Nixiujiade/4T_BLDC/[3]原理图/4T_AS5600/AS5600.pdf

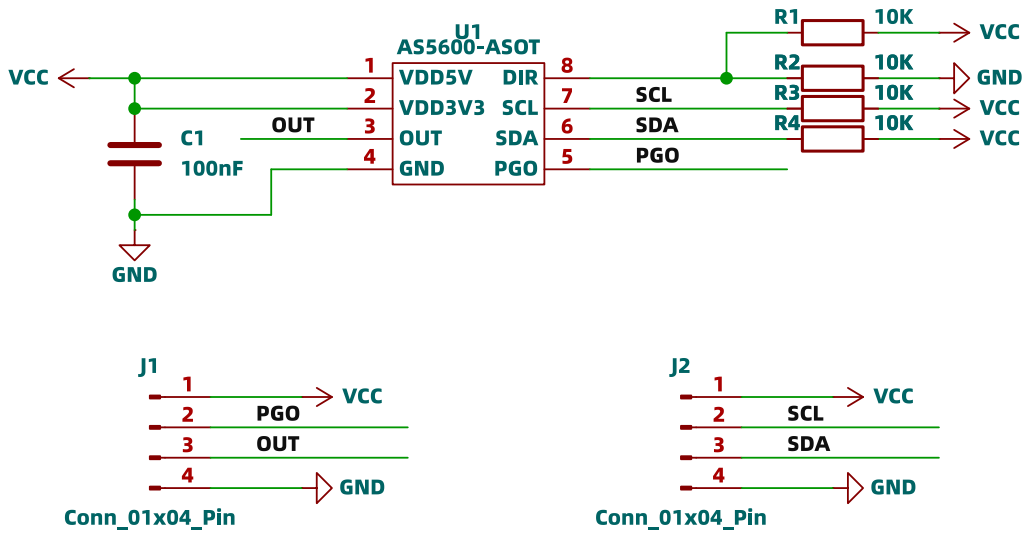
[picture p9: page 1]

Id: 1/1 Title: File: AS5600.kicad_sch Sheet: / 4T Tech
