Nixiujiade/4T_BLDC/[3]原理图/4T_FOC/4T_FOC.pdf

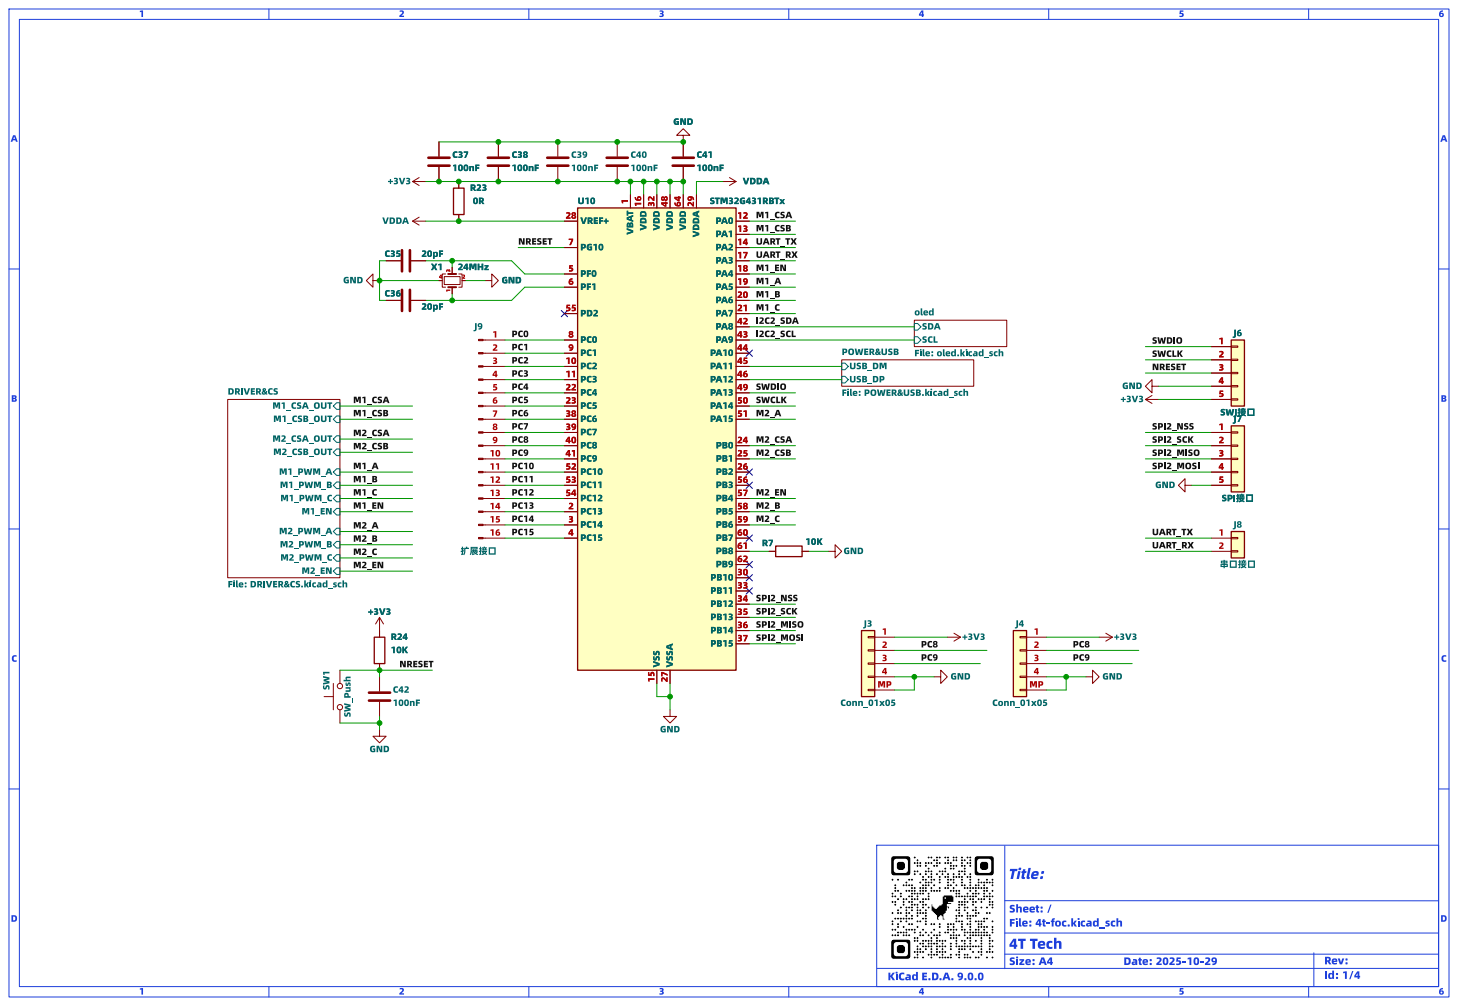
[picture p10: page 1]

1 VDD 16 VDD 32 VSS 15 VDD 48 VSSA 27 VDD 64 VDDA 29 PA0

þÿSWJc¥Sã GND

Id: 1/4 Title: File: 4t-foc.kicad_sch Sheet: / 4T Tech

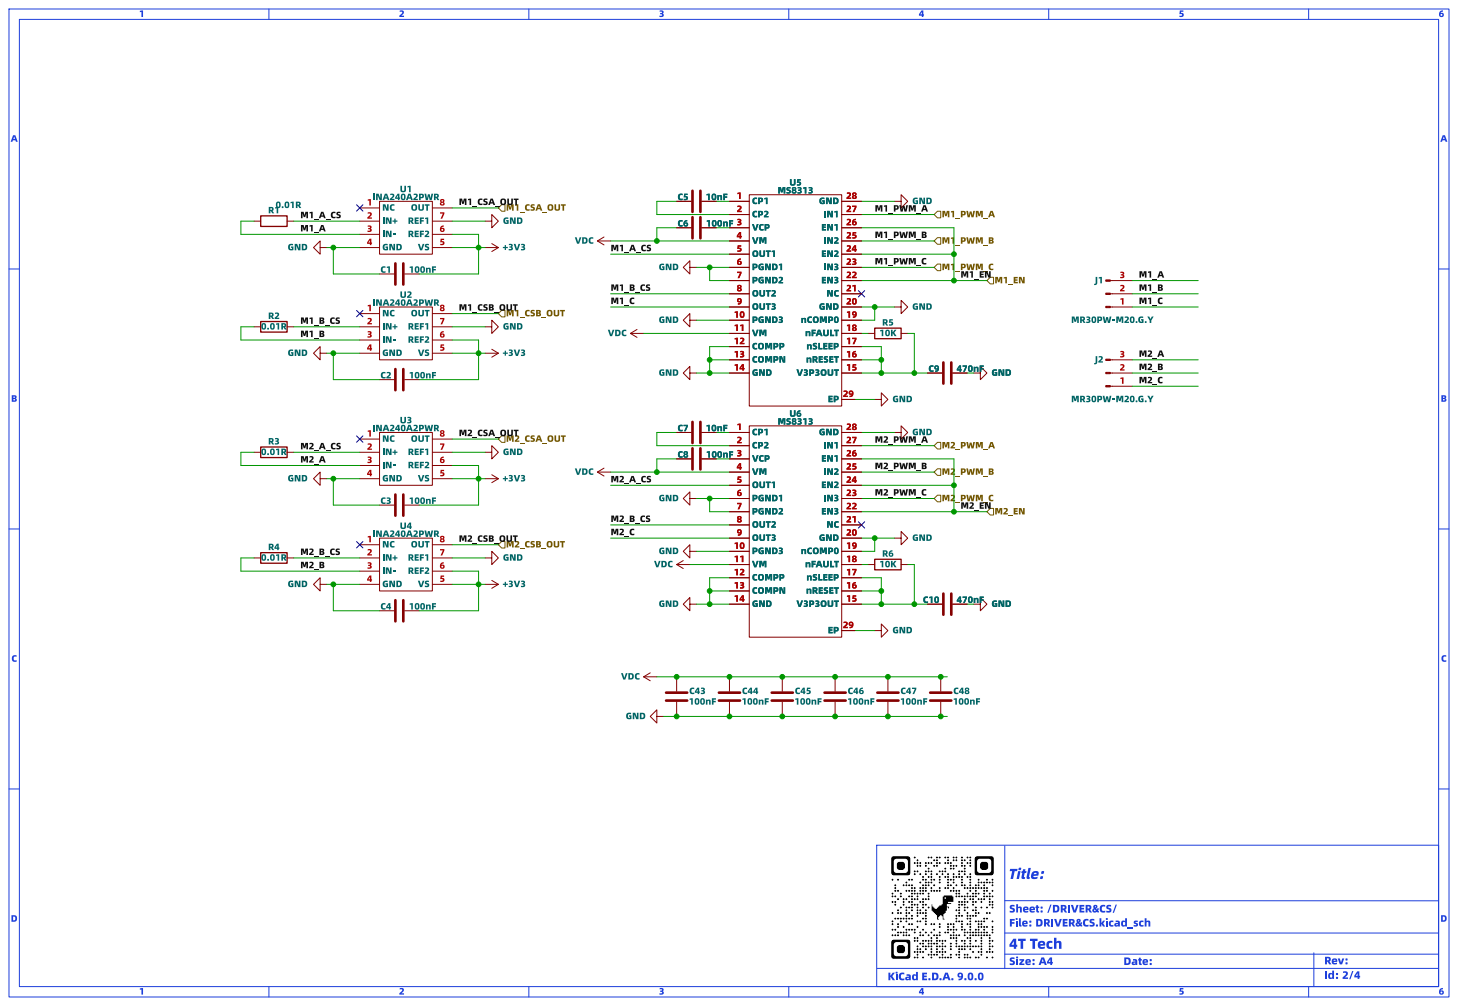
[picture p11: page 2]

Id: 2/4 Title: File: DRIVER&CS.kicad_sch Sheet: /DRIVER&CS/ 4T Tech

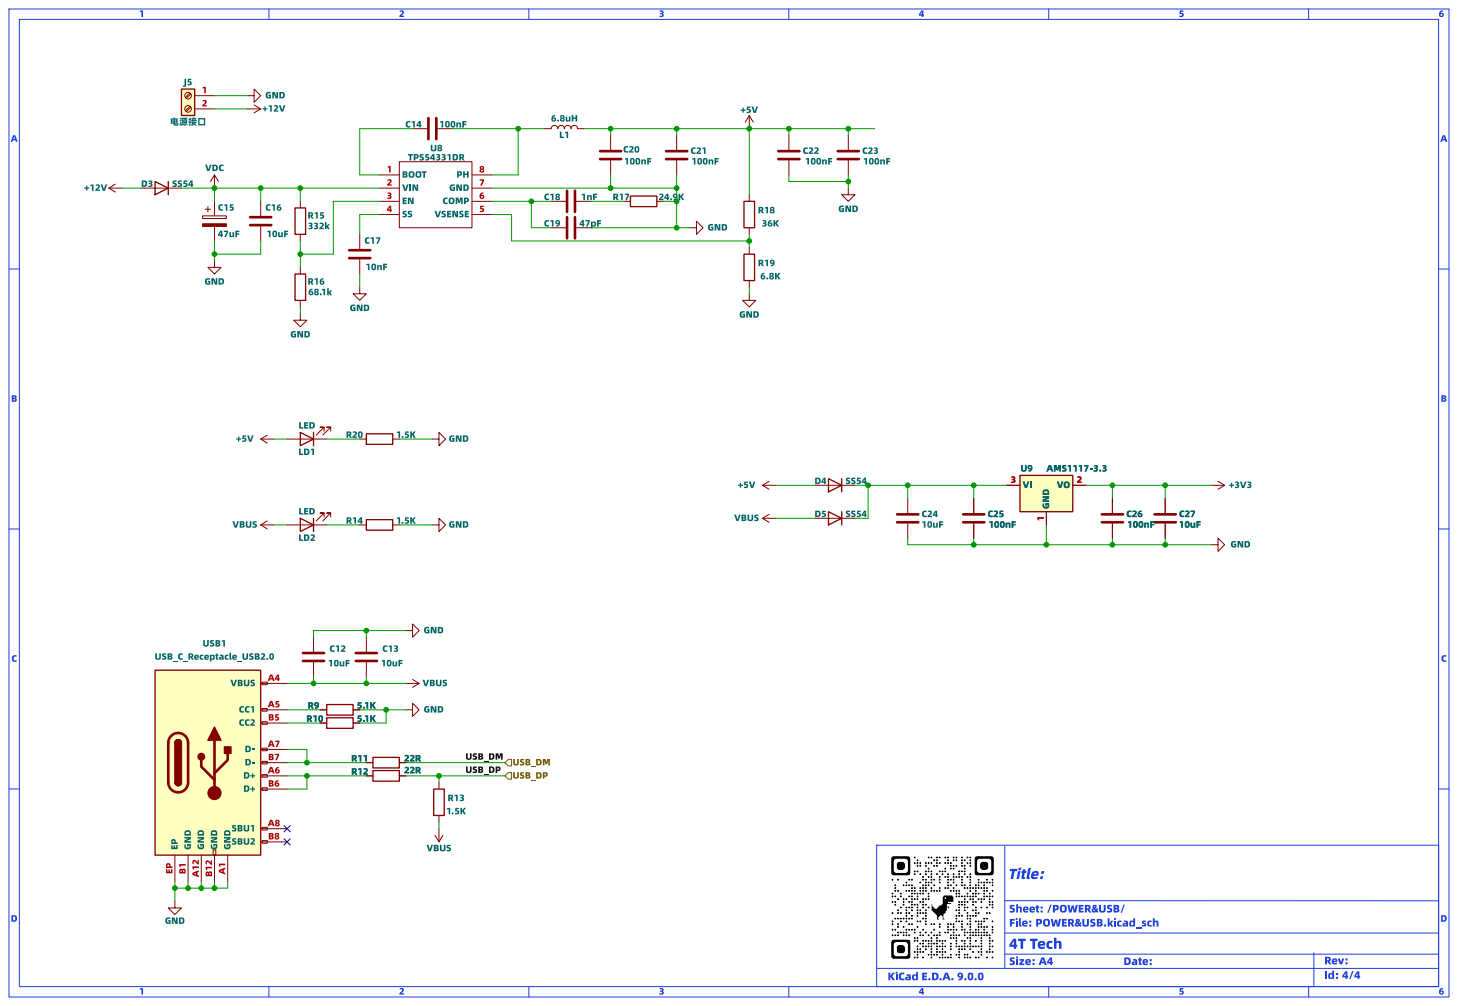
[picture p12: page 3]

Id: 4/4 Title: File: POWER&USB.kicad_sch Sheet: /POWER&USB/ 4T Tech

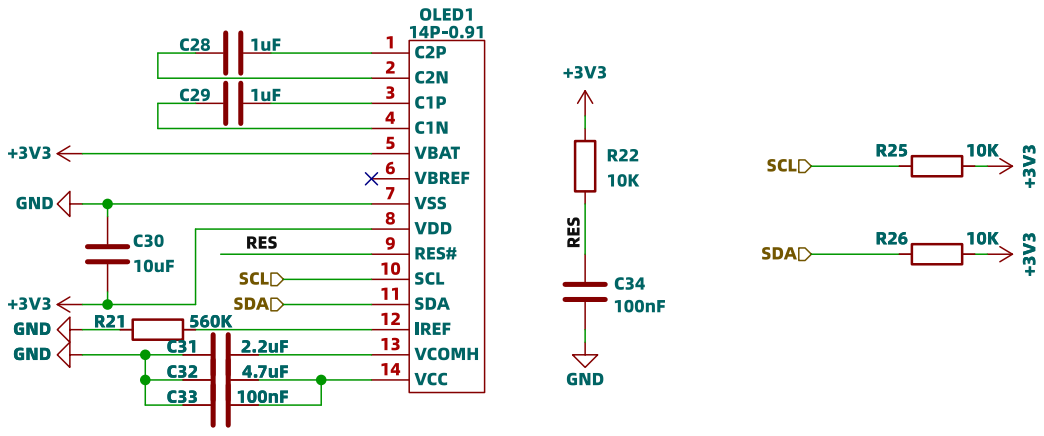
[picture p13: page 4]

Id: 5/4 Title: File: oled.kicad_sch Sheet: /oled/ 4T Tech
