Nixiujiade/4T_BLDC/[2]测试程序/MDK/Core/Src/main.c

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
/* Includes ------------------------------------------------------------------*/
#include "main.h"
#include "adc.h"
#include "dma.h"
#include "i2c.h"
#include "tim.h"
#include "usart.h"
#include "gpio.h"

/* USER CODE BEGIN Includes */
float target = 2;
float now_us1,now_us2;
/* USER CODE END Includes */


void SystemClock_Config(void);
/**
  * @brief  The application entry point.
  * @retval int
  */
int main(void)
{
  /* MCU Configuration--------------------------------------------------------*/

  /* Reset of all peripherals, Initializes the Flash interface and the Systick. */
  HAL_Init();

  /* Configure the system clock */
  SystemClock_Config();

  /* Initialize all configured peripherals */
  MX_GPIO_Init();
  MX_DMA_Init();
  MX_ADC1_Init();
  MX_ADC2_Init();
  MX_TIM2_Init();
  MX_TIM3_Init();
  MX_I2C3_Init();
  MX_USART2_UART_Init();
  MX_I2C2_Init();
  /* USER CODE BEGIN 2 */
	Debug_Init();
	
	HAL_TIM_PWM_Start(&htim2,TIM_CHANNEL_1);
	HAL_TIM_PWM_Start(&htim3,TIM_CHANNEL_1);
  HAL_TIM_PWM_Start(&htim3,TIM_CHANNEL_2);
	HAL_Delay(1000);
	MagneticSensor_Init();
	
	LPF_init();                //LPF参数初始化
	PID_init();                //PID参数初始化
	
	voltage_power_supply=12;   //V 电源电压
	pole_pairs=7;              //电机极对数，按照实际设置，虽然可以上电检测但有失败的概率
	voltage_sensor_align=1;    //V alignSensor() use it，航模电机设置的值小一点比如0.5-1，云台电机设置的大一点比如2-3
	voltage_limit=4.5;         //V，主要为限制电机最大电流，最大值需小于12/1.732=6.9
	velocity_limit=20;         //rad/s 角度模式时限制最大转速，力矩模式和速度模式不起作用
	current_limit=0.2;          //A，foc_current 和dc_current模式限制电流，不能为0。速度模式和位置模式起作用
	torque_controller=Type_voltage;  //Type_dc_current;//  Type_foc_current;  //Type_voltage;
	controller=Type_angle;  //Type_torque;  //Type_velocity;  //Type_angle; 
	PID_velocity.output_ramp=30; //速度爬升斜率，如果不需要可以设置为0
	LPF_velocity.Tf=0.001;      //Tf设置小一点，配合爬升斜率设置，速度切换更平稳；如果没有爬升模式的斜率限制，Tf太小电机容易抖动。
	target=10;
	
	M0_Enable;
	
	Motor_init();
	Motor_initFOC(0,UNKNOWN);  //(0,UNKNOWN);  //(1.1,CW); 第一次先获得偏移角和方向，填入代码编译后再下载，以后可以跳过零点校准
	printf("Motor ready.\r\n");
	
	
	oled_init();
  /* USER CODE END 2 */
	

  /* Infinite loop */
  /* USER CODE BEGIN WHILE */
  while (1)
  {
    /* USER CODE END WHILE */

    /* USER CODE BEGIN 3 */
		move(target);
		loopFOC();
	}
  /* USER CODE END 3 */
}

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
/* USER CODE BEGIN 4 */
int fputc(int ch,FILE *f)
{
	uint8_t temp[1]={ch};
	LL_USART_TransmitData8(USART2,temp[0]);
	while(!LL_USART_IsActiveFlag_TXE(USART2));//需要等待发送完成
	return(ch);
}
/* USER CODE END 4 */

/**
  * @brief  Period elapsed callback in non blocking mode
  * @note   This function is called  when TIM1 interrupt took place, inside
  * HAL_TIM_IRQHandler(). It makes a direct call to HAL_IncTick() to increment
  * a global variable "uwTick" used as application time base.
  * @param  htim : TIM handle
  * @retval None
  */
void HAL_TIM_PeriodElapsedCallback(TIM_HandleTypeDef *htim)
{
  if (htim->Instance == TIM1) {
    HAL_IncTick();
  }
}

/**
  * @brief  This function is executed in case of error occurrence.
  * @retval None
  */
void Error_Handler(void)
{
  /* USER CODE BEGIN Error_Handler_Debug */
  /* User can add his own implementation to report the HAL error return state */
  __disable_irq();
  while (1)
  {
  }
  /* USER CODE END Error_Handler_Debug */
}

#ifdef  USE_FULL_ASSERT
/**
  * @brief  Reports the name of the source file and the source line number
  *         where the assert_param error has occurred.
  * @param  file: pointer to the source file name
  * @param  line: assert_param error line source number
  * @retval None
  */
void assert_failed(uint8_t *file, uint32_t line)
{
  /* USER CODE BEGIN 6 */
  /* User can add his own implementation to report the file name and line number,
     ex: printf("Wrong parameters value: file %s on line %d\r\n", file, line) */
  /* USER CODE END 6 */
}
#endif /* USE_FULL_ASSERT */
