Nixiujiade/4T_BLDC/[2]测试程序/MDK/ll_4tfoc.ioc

Mcu.UserName=STM32G431RBTx
PA0.Signal=ADC1_IN1
PA1.Signal=ADC2_IN2
PA11.Signal=USB_DM
PA12.Signal=USB_DP
PA13.Signal=SYS_JTMS-SWDIO
PA14.Signal=SYS_JTCK-SWCLK
PA15.Signal=S_TIM8_CH1
PA2.Signal=USART2_TX
PA3.Signal=USART2_RX
PA4.Signal=GPIO_Output
PA5.Signal=S_TIM2_CH1
PA6.Signal=S_TIM3_CH1
PA7.Signal=S_TIM3_CH2
PA8.Signal=I2C2_SDA
PA9.Signal=I2C2_SCL
PB0.Signal=ADC1_IN15
PB1.Signal=ADC1_IN12
PB12.Signal=SPI2_NSS
PB13.Signal=SPI2_SCK
PB14.Signal=SPI2_MISO
PB15.Signal=SPI2_MOSI
PB4.Signal=GPIO_Output
PB5.Signal=S_TIM17_CH1
PB6.Signal=S_TIM4_CH1
PC8.Signal=I2C3_SCL
PC9.Signal=I2C3_SDA
PF0-OSC_IN.Signal=RCC_OSC_IN
PF1-OSC_OUT.Signal=RCC_OSC_OUT
