Nixiujiade/4T_BLDC/[2]测试程序/MDK/foc/BLDCMotor.h

#ifndef BLDCMotor_H
#define BLDCMotor_H

#include "main.h"


typedef enum
{
    CW      = 1,  //clockwise
    CCW     = -1, // counter clockwise
    UNKNOWN = 0   //not yet known or invalid state
} Direction;

extern long sensor_direction;
extern float voltage_power_supply;
extern float voltage_limit;
extern float voltage_sensor_align;
extern int  pole_pairs;
extern unsigned long open_loop_timestamp;
extern float velocity_limit;
extern float current_limit;

void Motor_init(void);
void Motor_initFOC(float zero_electric_offset, Direction _sensor_direction);
void loopFOC(void);
void move(float new_target);
void setPhaseVoltage(float Uq, float Ud, float angle_el);


#endif
