Nixiujiade/4T_BLDC/[2]测试程序/MDK/foc/Encoder.h

#ifndef __ENCODER_LIB_H
#define __ENCODER_LIB_H


#include "stm32g4xx.h"

/******************************************************************************/
/******************************************************************************/
void TIM3_Encoder_Init(void);
uint16_t ReadABZ(void);
void EXTI_Encoder_Init(void);
/******************************************************************************/

#endif
