Nixiujiade/4T_BLDC/[2]测试程序/MDK/Core/Inc/main.h

#define M0_Enable    HAL_GPIO_WritePin(GPIOA, GPIO_PIN_4, GPIO_PIN_SET); 
#define M0_Disable   HAL_GPIO_WritePin(GPIOA, GPIO_PIN_4, GPIO_PIN_RESET);   
