Nixiujiade/4T_BLDC/[2]测试程序/MDK/Core/Src/adc.c

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
/* Includes ------------------------------------------------------------------*/
#include "adc.h"

/* ADC1 init function */
void MX_ADC1_Init(void)
{

  LL_ADC_InitTypeDef ADC_InitStruct = {0};
  LL_ADC_REG_InitTypeDef ADC_REG_InitStruct = {0};
  LL_ADC_CommonInitTypeDef ADC_CommonInitStruct = {0};

  LL_GPIO_InitTypeDef GPIO_InitStruct = {0};

  LL_RCC_SetADCClockSource(LL_RCC_ADC12_CLKSOURCE_SYSCLK);

  /* Peripheral clock enable */
  LL_AHB2_GRP1_EnableClock(LL_AHB2_GRP1_PERIPH_ADC12);

  LL_AHB2_GRP1_EnableClock(LL_AHB2_GRP1_PERIPH_GPIOA);
  /**ADC1 GPIO Configuration
  PA0   ------> ADC1_IN1
  */
  GPIO_InitStruct.Pin = LL_GPIO_PIN_0;
  GPIO_InitStruct.Mode = LL_GPIO_MODE_ANALOG;
  GPIO_InitStruct.Pull = LL_GPIO_PULL_NO;
  LL_GPIO_Init(GPIOA, &GPIO_InitStruct);

  /* ADC1 DMA Init */

  /* ADC1 Init */
  LL_DMA_SetPeriphRequest(DMA2, LL_DMA_CHANNEL_1, LL_DMAMUX_REQ_ADC1);

  LL_DMA_SetDataTransferDirection(DMA2, LL_DMA_CHANNEL_1, LL_DMA_DIRECTION_PERIPH_TO_MEMORY);

  LL_DMA_SetChannelPriorityLevel(DMA2, LL_DMA_CHANNEL_1, LL_DMA_PRIORITY_HIGH);

  LL_DMA_SetMode(DMA2, LL_DMA_CHANNEL_1, LL_DMA_MODE_CIRCULAR);

  LL_DMA_SetPeriphIncMode(DMA2, LL_DMA_CHANNEL_1, LL_DMA_PERIPH_NOINCREMENT);

  LL_DMA_SetMemoryIncMode(DMA2, LL_DMA_CHANNEL_1, LL_DMA_MEMORY_NOINCREMENT);

  LL_DMA_SetPeriphSize(DMA2, LL_DMA_CHANNEL_1, LL_DMA_PDATAALIGN_HALFWORD);

  LL_DMA_SetMemorySize(DMA2, LL_DMA_CHANNEL_1, LL_DMA_MDATAALIGN_HALFWORD);

  /** Common config
  */
  ADC_InitStruct.Resolution = LL_ADC_RESOLUTION_12B;
  ADC_InitStruct.DataAlignment = LL_ADC_DATA_ALIGN_RIGHT;
  ADC_InitStruct.LowPowerMode = LL_ADC_LP_MODE_NONE;
  LL_ADC_Init(ADC1, &ADC_InitStruct);
  ADC_REG_InitStruct.TriggerSource = LL_ADC_REG_TRIG_SOFTWARE;
  ADC_REG_InitStruct.SequencerLength = LL_ADC_REG_SEQ_SCAN_DISABLE;
  ADC_REG_InitStruct.SequencerDiscont = LL_ADC_REG_SEQ_DISCONT_DISABLE;
  ADC_REG_InitStruct.ContinuousMode = LL_ADC_REG_CONV_SINGLE;
  ADC_REG_InitStruct.DMATransfer = LL_ADC_REG_DMA_TRANSFER_LIMITED;
  ADC_REG_InitStruct.Overrun = LL_ADC_REG_OVR_DATA_PRESERVED;
  LL_ADC_REG_Init(ADC1, &ADC_REG_InitStruct);
  LL_ADC_SetGainCompensation(ADC1, 0);
  LL_ADC_SetOverSamplingScope(ADC1, LL_ADC_OVS_DISABLE);
  ADC_CommonInitStruct.CommonClock = LL_ADC_CLOCK_SYNC_PCLK_DIV4;
  ADC_CommonInitStruct.Multimode = LL_ADC_MULTI_INDEPENDENT;
  LL_ADC_CommonInit(__LL_ADC_COMMON_INSTANCE(ADC1), &ADC_CommonInitStruct);

  /* Disable ADC deep power down (enabled by default after reset state) */
  LL_ADC_DisableDeepPowerDown(ADC1);
  /* Enable ADC internal voltage regulator */
  LL_ADC_EnableInternalRegulator(ADC1);
  /* Delay for ADC internal voltage regulator stabilization. */
  /* Compute number of CPU cycles to wait for, from delay in us. */
  /* Note: Variable divided by 2 to compensate partially */
  /* CPU processing cycles (depends on compilation optimization). */
  /* Note: If system core clock frequency is below 200kHz, wait time */
  /* is only a few CPU processing cycles. */
  uint32_t wait_loop_index;
  wait_loop_index = ((LL_ADC_DELAY_INTERNAL_REGUL_STAB_US * (SystemCoreClock / (100000 * 2))) / 10);
  while(wait_loop_index != 0)
  {
    wait_loop_index--;
  }

  /** Configure Regular Channel
  */
  LL_ADC_REG_SetSequencerRanks(ADC1, LL_ADC_REG_RANK_1, LL_ADC_CHANNEL_1);
  LL_ADC_SetChannelSamplingTime(ADC1, LL_ADC_CHANNEL_1, LL_ADC_SAMPLINGTIME_2CYCLES_5);
  LL_ADC_SetChannelSingleDiff(ADC1, LL_ADC_CHANNEL_1, LL_ADC_SINGLE_ENDED);
}
/* ADC2 init function */
void MX_ADC2_Init(void)
{

  LL_ADC_InitTypeDef ADC_InitStruct = {0};
  LL_ADC_REG_InitTypeDef ADC_REG_InitStruct = {0};

  LL_GPIO_InitTypeDef GPIO_InitStruct = {0};

  LL_RCC_SetADCClockSource(LL_RCC_ADC12_CLKSOURCE_SYSCLK);

  /* Peripheral clock enable */
  LL_AHB2_GRP1_EnableClock(LL_AHB2_GRP1_PERIPH_ADC12);

  LL_AHB2_GRP1_EnableClock(LL_AHB2_GRP1_PERIPH_GPIOA);
  /**ADC2 GPIO Configuration
  PA1   ------> ADC2_IN2
  */
  GPIO_InitStruct.Pin = LL_GPIO_PIN_1;
  GPIO_InitStruct.Mode = LL_GPIO_MODE_ANALOG;
  GPIO_InitStruct.Pull = LL_GPIO_PULL_NO;
  LL_GPIO_Init(GPIOA, &GPIO_InitStruct);

  /* ADC2 DMA Init */

  /* ADC2 Init */
  LL_DMA_SetPeriphRequest(DMA2, LL_DMA_CHANNEL_2, LL_DMAMUX_REQ_ADC2);

  LL_DMA_SetDataTransferDirection(DMA2, LL_DMA_CHANNEL_2, LL_DMA_DIRECTION_PERIPH_TO_MEMORY);

  LL_DMA_SetChannelPriorityLevel(DMA2, LL_DMA_CHANNEL_2, LL_DMA_PRIORITY_HIGH);

  LL_DMA_SetMode(DMA2, LL_DMA_CHANNEL_2, LL_DMA_MODE_CIRCULAR);

  LL_DMA_SetPeriphIncMode(DMA2, LL_DMA_CHANNEL_2, LL_DMA_PERIPH_NOINCREMENT);

  LL_DMA_SetMemoryIncMode(DMA2, LL_DMA_CHANNEL_2, LL_DMA_MEMORY_NOINCREMENT);

  LL_DMA_SetPeriphSize(DMA2, LL_DMA_CHANNEL_2, LL_DMA_PDATAALIGN_HALFWORD);

  LL_DMA_SetMemorySize(DMA2, LL_DMA_CHANNEL_2, LL_DMA_MDATAALIGN_HALFWORD);

  /** Common config
  */
  ADC_InitStruct.Resolution = LL_ADC_RESOLUTION_12B;
  ADC_InitStruct.DataAlignment = LL_ADC_DATA_ALIGN_RIGHT;
  ADC_InitStruct.LowPowerMode = LL_ADC_LP_MODE_NONE;
  LL_ADC_Init(ADC2, &ADC_InitStruct);
  ADC_REG_InitStruct.TriggerSource = LL_ADC_REG_TRIG_SOFTWARE;
  ADC_REG_InitStruct.SequencerLength = LL_ADC_REG_SEQ_SCAN_DISABLE;
  ADC_REG_InitStruct.SequencerDiscont = LL_ADC_REG_SEQ_DISCONT_DISABLE;
  ADC_REG_InitStruct.ContinuousMode = LL_ADC_REG_CONV_SINGLE;
  ADC_REG_InitStruct.DMATransfer = LL_ADC_REG_DMA_TRANSFER_LIMITED;
  ADC_REG_InitStruct.Overrun = LL_ADC_REG_OVR_DATA_PRESERVED;
  LL_ADC_REG_Init(ADC2, &ADC_REG_InitStruct);
  LL_ADC_SetGainCompensation(ADC2, 0);
  LL_ADC_SetOverSamplingScope(ADC2, LL_ADC_OVS_DISABLE);

  /* Disable ADC deep power down (enabled by default after reset state) */
  LL_ADC_DisableDeepPowerDown(ADC2);
  /* Enable ADC internal voltage regulator */
  LL_ADC_EnableInternalRegulator(ADC2);
  /* Delay for ADC internal voltage regulator stabilization. */
  /* Compute number of CPU cycles to wait for, from delay in us. */
  /* Note: Variable divided by 2 to compensate partially */
  /* CPU processing cycles (depends on compilation optimization). */
  /* Note: If system core clock frequency is below 200kHz, wait time */
  /* is only a few CPU processing cycles. */
  uint32_t wait_loop_index;
  wait_loop_index = ((LL_ADC_DELAY_INTERNAL_REGUL_STAB_US * (SystemCoreClock / (100000 * 2))) / 10);
  while(wait_loop_index != 0)
  {
    wait_loop_index--;
  }

  /** Configure Regular Channel
  */
  LL_ADC_REG_SetSequencerRanks(ADC2, LL_ADC_REG_RANK_1, LL_ADC_CHANNEL_2);
  LL_ADC_SetChannelSamplingTime(ADC2, LL_ADC_CHANNEL_2, LL_ADC_SAMPLINGTIME_2CYCLES_5);
  LL_ADC_SetChannelSingleDiff(ADC2, LL_ADC_CHANNEL_2, LL_ADC_SINGLE_ENDED);
}

/* USER CODE BEGIN 1 */

#define bufSize   1
uint16_t buf2[bufSize]={0};
uint32_t Value2=0;
float endValue2=0;


float AdcToDmaGetValue2(void)
{
//	HAL_ADC_Start_DMA(&hadc2,(uint32_t*)buf2,bufSize);
//    //等待DMA搬运完成
//	while(__HAL_DMA_GET_FLAG(&hdma_adc2,DMA_FLAG_TC2))
//	{
//        //hdma_adc2要进行外部声明，cbuemx生成时选分别生产.c .h文件即可在adc.c中找到
//		__HAL_DMA_CLEAR_FLAG(&hdma_adc2,DMA_FLAG_TC2);
//        //这个函数是必要的不然标志位查看时会一直卡住
//		HAL_ADC_Stop_DMA(&hadc2);
//	}
//	for(int i=0;i<bufSize;++i)
//	{
//		Value2=buf2[i];
//	}
//	endValue2=(float)Value2*(3.3f/4096.0f);
	return endValue2;
}

uint16_t buf1[bufSize]={0};
uint32_t Value1=0;
float endValue1=0;


float AdcToDmaGetValue1(void)
{
//	HAL_ADC_Start_DMA(&hadc1,(uint32_t*)buf1,bufSize);
//    //等待DMA搬运完成
//	while(__HAL_DMA_GET_FLAG(&hdma_adc1,DMA_FLAG_TC1))
//	{
//        //hdma_adc1要进行外部声明，cbuemx生成时选分别生产.c .h文件即可在adc.c中找到
//		__HAL_DMA_CLEAR_FLAG(&hdma_adc1,DMA_FLAG_TC1);
//        //这个函数是必要的不然标志位查看时会一直卡住
//		HAL_ADC_Stop_DMA(&hadc1);
//	}
//	for(int i=0;i<bufSize;++i)
//	{
//		Value1=buf1[i];
//	}
//	endValue1=(float)Value1*(3.3f/4096.0f);
	return endValue1;
}
/* USER CODE END 1 */
