Nixiujiade/4T_BLDC/[2]测试程序/MDK/Core/Src/usart.c

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
/* Includes ------------------------------------------------------------------*/
#include "usart.h"

/* USER CODE BEGIN 0 */

uart_parameter uart_data;

/* USER CODE END 0 */

/* USART2 init function */

void MX_USART2_UART_Init(void)
{

  LL_USART_InitTypeDef USART_InitStruct = {0};

  LL_GPIO_InitTypeDef GPIO_InitStruct = {0};

  LL_RCC_SetUSARTClockSource(LL_RCC_USART2_CLKSOURCE_PCLK1);

  /* Peripheral clock enable */
  LL_APB1_GRP1_EnableClock(LL_APB1_GRP1_PERIPH_USART2);

  LL_AHB2_GRP1_EnableClock(LL_AHB2_GRP1_PERIPH_GPIOA);
  /**USART2 GPIO Configuration
  PA2   ------> USART2_TX
  PA3   ------> USART2_RX
  */
  GPIO_InitStruct.Pin = LL_GPIO_PIN_2;
  GPIO_InitStruct.Mode = LL_GPIO_MODE_ALTERNATE;
  GPIO_InitStruct.Speed = LL_GPIO_SPEED_FREQ_LOW;
  GPIO_InitStruct.OutputType = LL_GPIO_OUTPUT_PUSHPULL;
  GPIO_InitStruct.Pull = LL_GPIO_PULL_NO;
  GPIO_InitStruct.Alternate = LL_GPIO_AF_7;
  LL_GPIO_Init(GPIOA, &GPIO_InitStruct);

  GPIO_InitStruct.Pin = LL_GPIO_PIN_3;
  GPIO_InitStruct.Mode = LL_GPIO_MODE_ALTERNATE;
  GPIO_InitStruct.Speed = LL_GPIO_SPEED_FREQ_LOW;
  GPIO_InitStruct.OutputType = LL_GPIO_OUTPUT_PUSHPULL;
  GPIO_InitStruct.Pull = LL_GPIO_PULL_NO;
  GPIO_InitStruct.Alternate = LL_GPIO_AF_7;
  LL_GPIO_Init(GPIOA, &GPIO_InitStruct);

  /* USART2 DMA Init */

  /* USART2_RX Init */
  LL_DMA_SetPeriphRequest(DMA1, LL_DMA_CHANNEL_1, LL_DMAMUX_REQ_USART2_RX);

  LL_DMA_SetDataTransferDirection(DMA1, LL_DMA_CHANNEL_1, LL_DMA_DIRECTION_PERIPH_TO_MEMORY);

  LL_DMA_SetChannelPriorityLevel(DMA1, LL_DMA_CHANNEL_1, LL_DMA_PRIORITY_LOW);

  LL_DMA_SetMode(DMA1, LL_DMA_CHANNEL_1, LL_DMA_MODE_NORMAL);

  LL_DMA_SetPeriphIncMode(DMA1, LL_DMA_CHANNEL_1, LL_DMA_PERIPH_NOINCREMENT);

  LL_DMA_SetMemoryIncMode(DMA1, LL_DMA_CHANNEL_1, LL_DMA_MEMORY_INCREMENT);

  LL_DMA_SetPeriphSize(DMA1, LL_DMA_CHANNEL_1, LL_DMA_PDATAALIGN_BYTE);

  LL_DMA_SetMemorySize(DMA1, LL_DMA_CHANNEL_1, LL_DMA_MDATAALIGN_BYTE);

  /* USART2_TX Init */
  LL_DMA_SetPeriphRequest(DMA1, LL_DMA_CHANNEL_2, LL_DMAMUX_REQ_USART2_TX);

  LL_DMA_SetDataTransferDirection(DMA1, LL_DMA_CHANNEL_2, LL_DMA_DIRECTION_MEMORY_TO_PERIPH);

  LL_DMA_SetChannelPriorityLevel(DMA1, LL_DMA_CHANNEL_2, LL_DMA_PRIORITY_MEDIUM);

  LL_DMA_SetMode(DMA1, LL_DMA_CHANNEL_2, LL_DMA_MODE_NORMAL);

  LL_DMA_SetPeriphIncMode(DMA1, LL_DMA_CHANNEL_2, LL_DMA_PERIPH_NOINCREMENT);

  LL_DMA_SetMemoryIncMode(DMA1, LL_DMA_CHANNEL_2, LL_DMA_MEMORY_INCREMENT);

  LL_DMA_SetPeriphSize(DMA1, LL_DMA_CHANNEL_2, LL_DMA_PDATAALIGN_BYTE);

  LL_DMA_SetMemorySize(DMA1, LL_DMA_CHANNEL_2, LL_DMA_MDATAALIGN_BYTE);

  /* USART2 interrupt Init */
  NVIC_SetPriority(USART2_IRQn, NVIC_EncodePriority(NVIC_GetPriorityGrouping(),0, 0));
  NVIC_EnableIRQ(USART2_IRQn);

  /* USER CODE BEGIN USART2_Init 1 */
	
	uart_data.flag = 0;
	uart_data.send_ok = 0;
  /* USER CODE END USART2_Init 1 */
  USART_InitStruct.PrescalerValue = LL_USART_PRESCALER_DIV1;
  USART_InitStruct.BaudRate = 115200;
  USART_InitStruct.DataWidth = LL_USART_DATAWIDTH_8B;
  USART_InitStruct.StopBits = LL_USART_STOPBITS_1;
  USART_InitStruct.Parity = LL_USART_PARITY_NONE;
  USART_InitStruct.TransferDirection = LL_USART_DIRECTION_TX_RX;
  USART_InitStruct.HardwareFlowControl = LL_USART_HWCONTROL_NONE;
  USART_InitStruct.OverSampling = LL_USART_OVERSAMPLING_16;
  LL_USART_Init(USART2, &USART_InitStruct);
  LL_USART_SetTXFIFOThreshold(USART2, LL_USART_FIFOTHRESHOLD_1_8);
  LL_USART_SetRXFIFOThreshold(USART2, LL_USART_FIFOTHRESHOLD_1_8);
  LL_USART_DisableFIFO(USART2);
  LL_USART_ConfigAsyncMode(USART2);

  LL_USART_Enable(USART2);

  /* Polling USART2 initialisation */
  while((!(LL_USART_IsActiveFlag_TEACK(USART2))) || (!(LL_USART_IsActiveFlag_REACK(USART2))))
  {
  }
}

/* USER CODE BEGIN 1 */

void Debug_Init(void)
{
    
	//配置串口方向，我这里是发送和接收都要
	LL_USART_SetTransferDirection(USART2,LL_USART_DIRECTION_TX_RX);

	/*接收配置*/
	//使能空闲中断
	LL_USART_EnableIT_IDLE(USART2);
	//设置内存地址，也就是设置接收的数据要放哪
	LL_DMA_SetMemoryAddress(DMA1,LL_DMA_CHANNEL_1,(uint32_t)uart_data.rcvbuff);
	//设置接收最大数据长度
	LL_DMA_SetDataLength(DMA1,LL_DMA_CHANNEL_1,256);
	//设置外设地址，也就是设置串口的数据寄存器
	LL_DMA_SetPeriphAddress(DMA1,LL_DMA_CHANNEL_1,(uint32_t)&USART2->RDR);
	//使能发送完成中断
	LL_DMA_EnableIT_TC(DMA1,LL_DMA_CHANNEL_1);
	//使能接收的
	LL_DMA_EnableChannel(DMA1, LL_DMA_CHANNEL_1);
	//使能DMA串口接收
	LL_USART_EnableDMAReq_RX(USART2);
	
	
//	/*发送配置*/
//	//设置外设地址，因为这个是DMA串口发送，
//	LL_DMA_SetPeriphAddress(DMA1,LL_DMA_CHANNEL_2,(uint32_t)&USART2->TDR);
//	//使能DMA串口发送
//	LL_USART_EnableDMAReq_TX(USART2);
//	//
//	LL_DMA_EnableIT_TC(DMA1,LL_DMA_CHANNEL_2);
}

//int printf(const char *fmt, ...)
//{
//    va_list arg;
//    int cnt;
//    char buffer[256];

//    va_start(arg,fmt);
//    cnt=vsprintf(buffer,fmt,arg);
//    va_end(arg);
//		LL_DMA_SetMemoryAddress(DMA1,LL_DMA_CHANNEL_2,(uint32_t)buffer);
// 
//		LL_DMA_SetDataLength(DMA1,LL_DMA_CHANNEL_2,strlen(buffer));
//    LL_DMA_EnableChannel(DMA1,LL_DMA_CHANNEL_2);
//		
//		while(uart_data.send_ok==1);
//		uart_data.send_ok = 0;
//    return cnt;
//}

/* USER CODE END 1 */
