Nixiujiade/4T_BLDC/(notices)

Notices in the files:
[2]测试程序/MDK/Core/Inc/main.h:
Copyright (c) 2024 STMicroelectronics.
All rights reserved.
This software is licensed under terms that can be found in the LICENSE file
